NWFSC-OA-lab/field_sensors/images/DataSheet Images/Pico-pH Parts.PNG

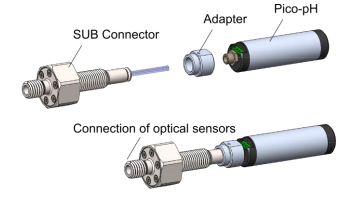
images/DataSheet Images/Pico-pH Parts.PNG
