NWFSC-OA-lab/field_sensors/README.md

# field_sensors
Repo for field sensor team files, issues and code
