NWFSC-OA-lab/field_sensors/ShuckMaster/README.md

# Logger
Arduino code for a Shuckmaster

## Features
 * Receives commands and responds over Bluetooth
 * Stores persistent configuration settings
   * Measurement period
   * Calibration constants
 * Keeps track of persistent time through an RTC module
 * Stores data on a microSD card
