NWFSC-OA-lab/field_sensors/ShuckManagerNew/ShuckManager/README.md

# ShuckManager
Android app mediating between the Shuckmaster and web server

## Features
 * Scans for nearby Shuckmasters and allows connection
 * Request data between two dates, then forward it to the web server
 * Configure a connected Shuckmaster
 * Set calibration constants on a connected Shuckmaster based on measurements in a standard solution
 * Request health of components on a connected Shuckmaster
