NWFSC-OA-lab/field_sensors/images/Conductivity sensor connections.PNG

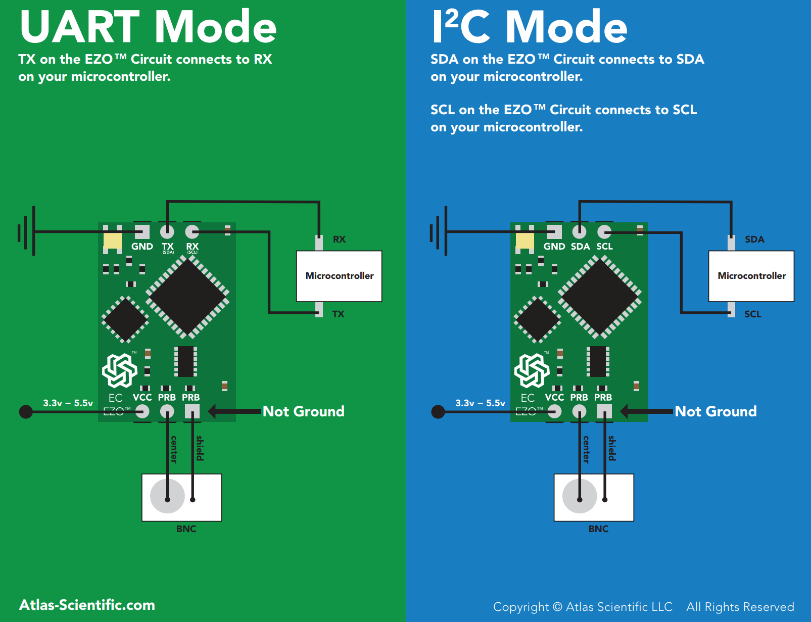
images/Conductivity sensor connections.PNG
