NWFSC-OA-lab/field_sensors/images/Conductivity Sensor/I2C Commands.PNG

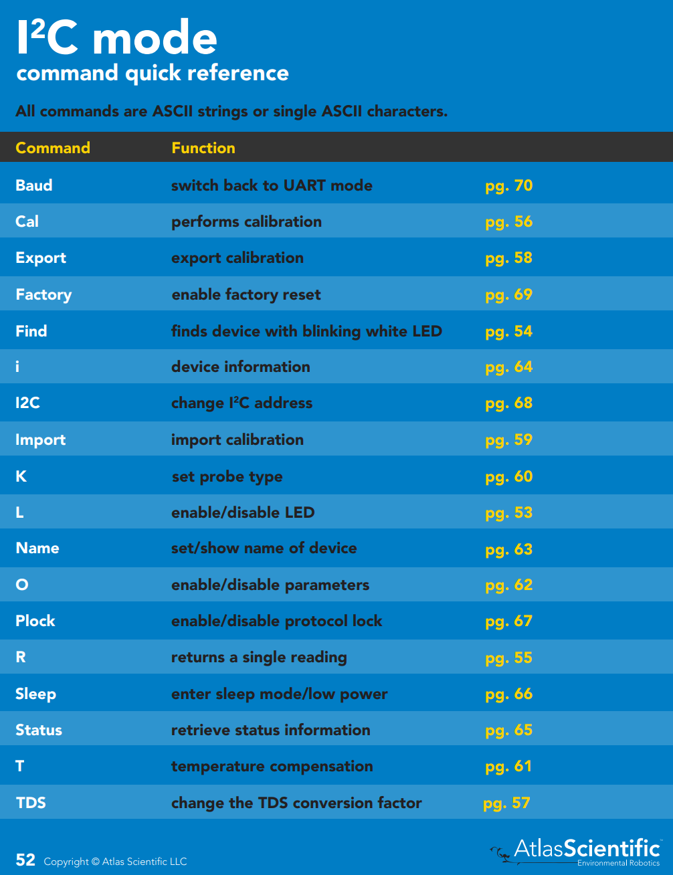
images/Conductivity Sensor/I2C Commands.PNG
