NWFSC-OA-lab/field_sensors/images/Conductivity Sensor/power ratings.PNG

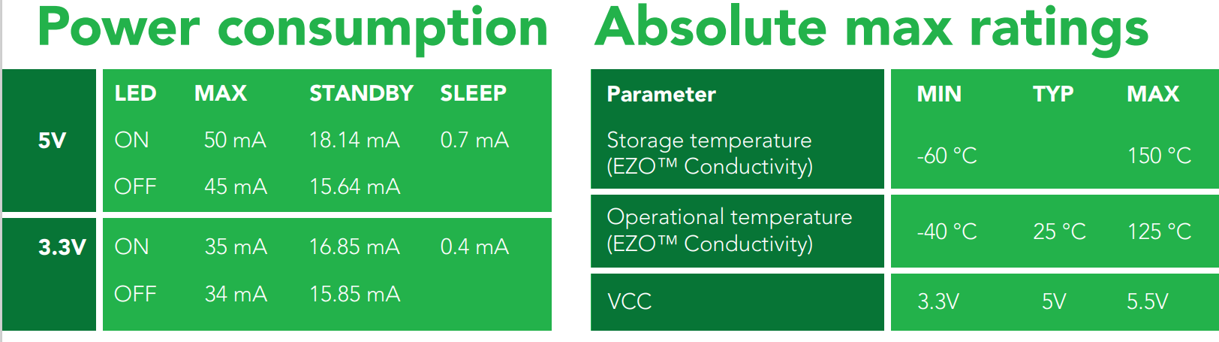
images/Conductivity Sensor/power ratings.PNG
