NWFSC-OA-lab/field_sensors/images/Conductivity Sensor/UART Commands.PNG

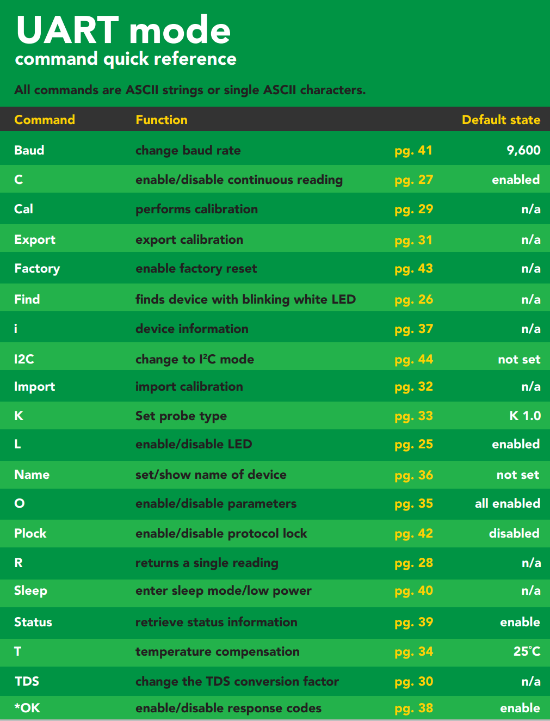
images/Conductivity Sensor/UART Commands.PNG
