NWFSC-OA-lab/field_sensors/images/DataSheet Images/conductivity sensor specifications.PNG

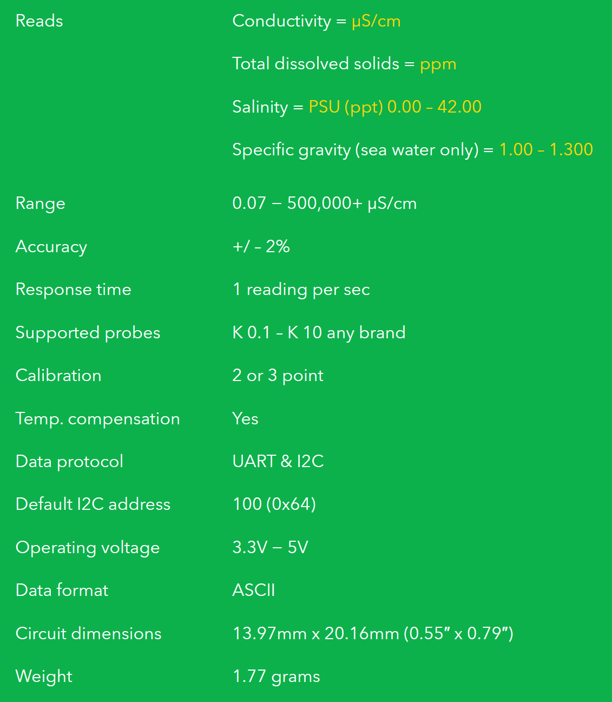
images/DataSheet Images/conductivity sensor specifications.PNG
