NWFSC-OA-lab/field_sensors/images/DataSheet Images/Durafet dimensions.PNG

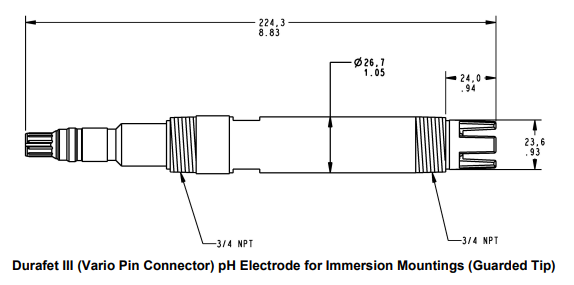
images/DataSheet Images/Durafet dimensions.PNG
