NWFSC-OA-lab/field_sensors/images/DataSheet Images/Durafet Specifications.PNG

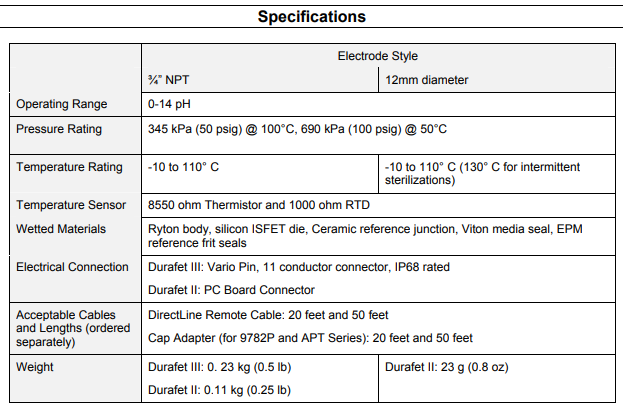
images/DataSheet Images/Durafet Specifications.PNG
