NWFSC-OA-lab/field_sensors/images/DataSheet Images/Pico-pH Specifications2.PNG

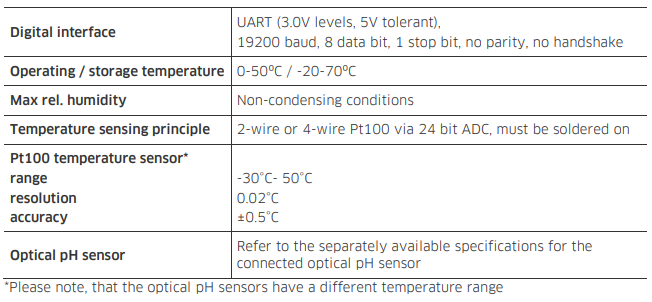
images/DataSheet Images/Pico-pH Specifications2.PNG
