NWFSC-OA-lab/field_sensors/images/DataSheet Images/Pico-pH Specifications.PNG

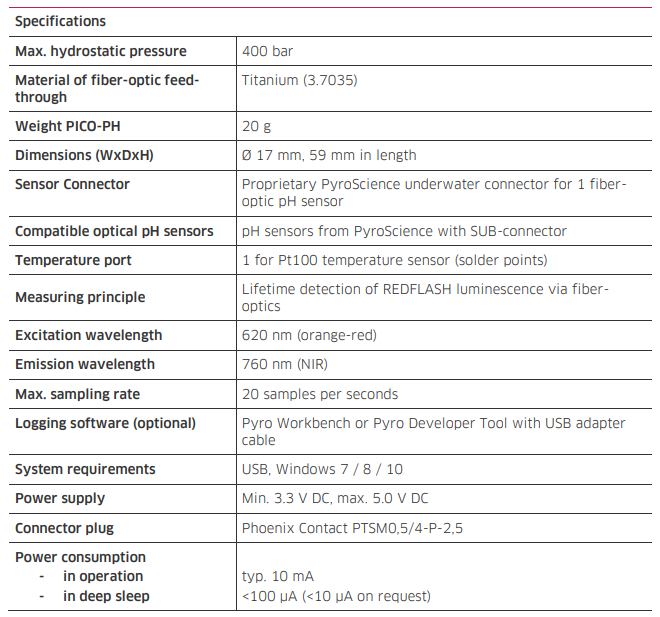
images/DataSheet Images/Pico-pH Specifications.PNG
