NWFSC-OA-lab/field_sensors/images/Schematic Images/ADC Schematic.PNG

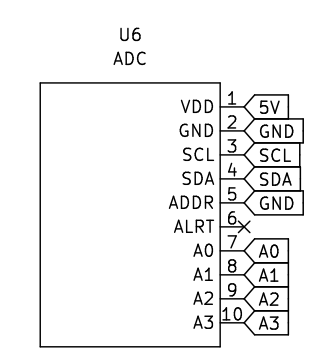
images/Schematic Images/ADC Schematic.PNG
