NWFSC-OA-lab/field_sensors/images/Schematic Images/Arduino Schematic.PNG

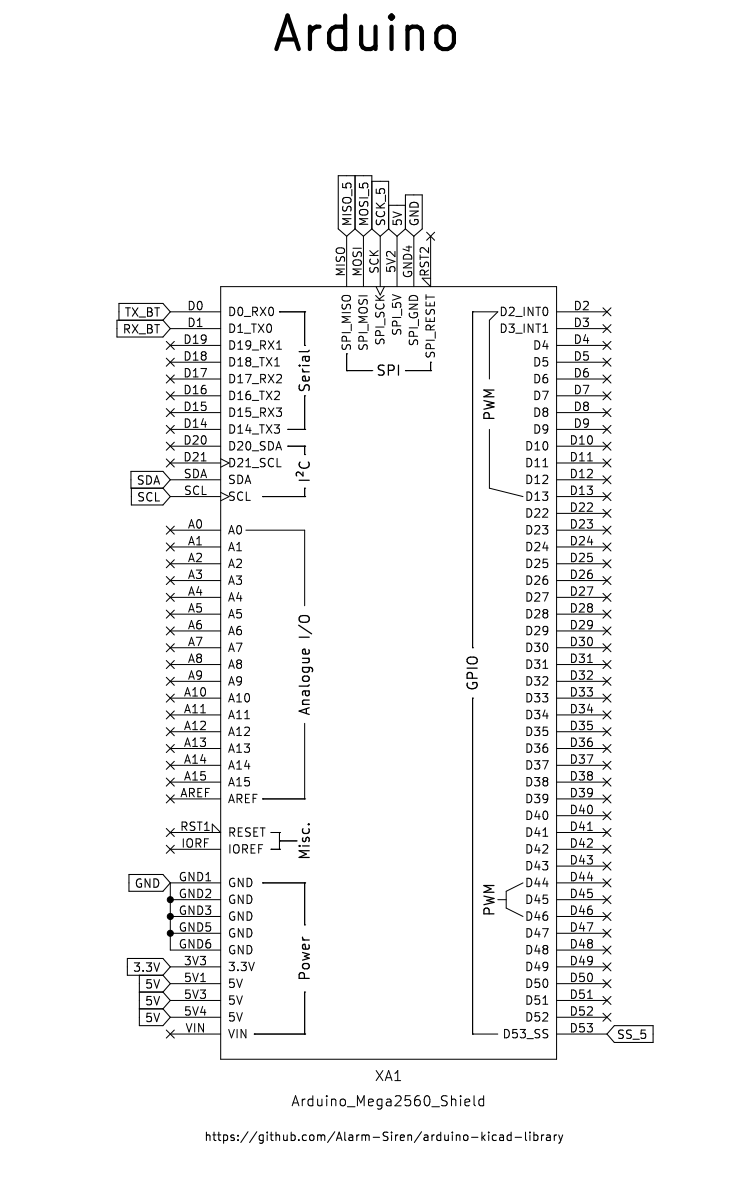
images/Schematic Images/Arduino Schematic.PNG
