NWFSC-OA-lab/field_sensors/images/Schematic Images/Barrel Jack Schematic.PNG

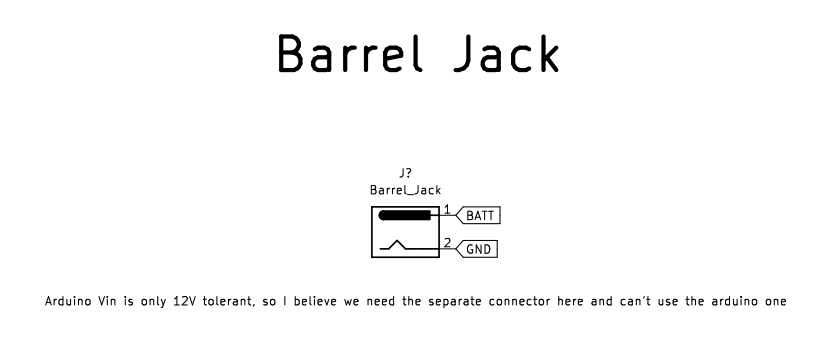
images/Schematic Images/Barrel Jack Schematic.PNG
