NWFSC-OA-lab/field_sensors/images/Schematic Images/Bluetooth Schematic.PNG

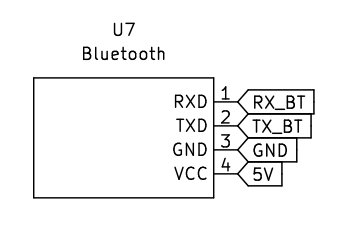
images/Schematic Images/Bluetooth Schematic.PNG
