NWFSC-OA-lab/field_sensors/images/Schematic Images/I2C Schematic.PNG

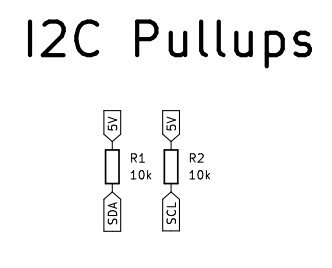
images/Schematic Images/I2C Schematic.PNG
