NWFSC-OA-lab/field_sensors/images/Schematic Images/Level Shifter Schematic.PNG

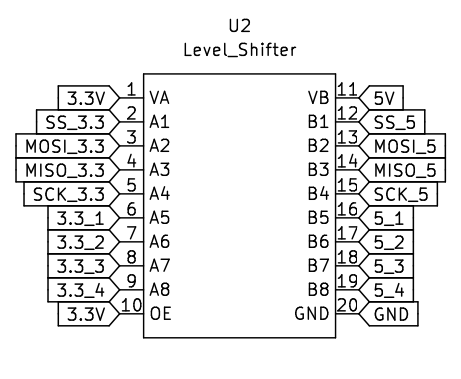
images/Schematic Images/Level Shifter Schematic.PNG
