NWFSC-OA-lab/field_sensors/images/Schematic Images/PCB design.PNG

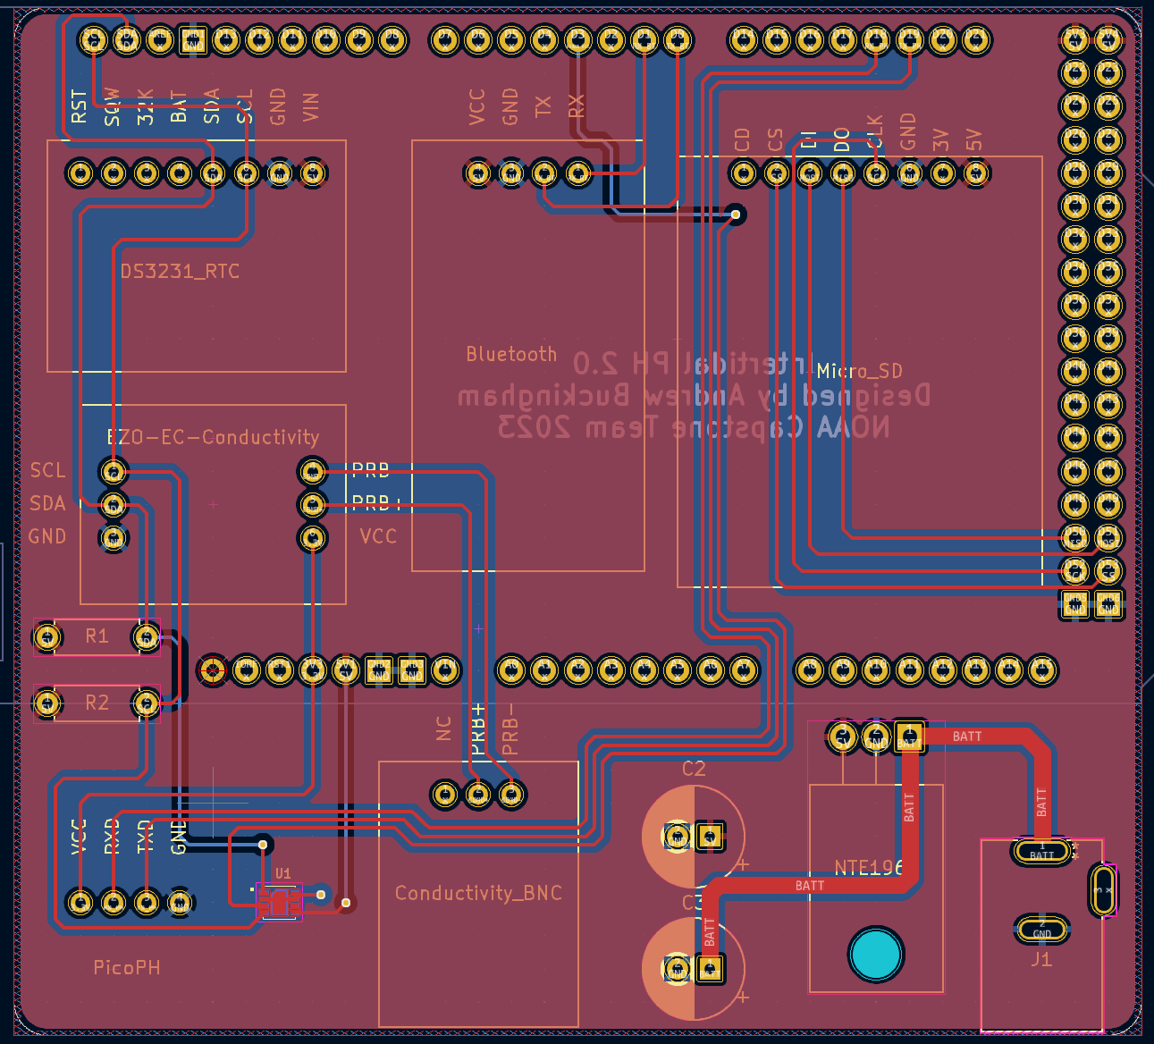
images/Schematic Images/PCB design.PNG
