NWFSC-OA-lab/field_sensors/images/Schematic Images/Power Flags Schematic.PNG

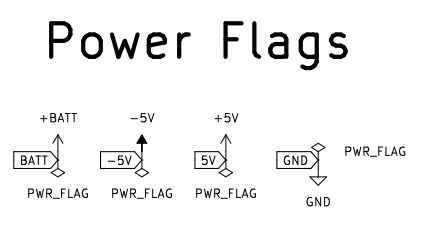
images/Schematic Images/Power Flags Schematic.PNG
