NWFSC-OA-lab/field_sensors/images/Schematic Images/SD Reader Schematic.PNG

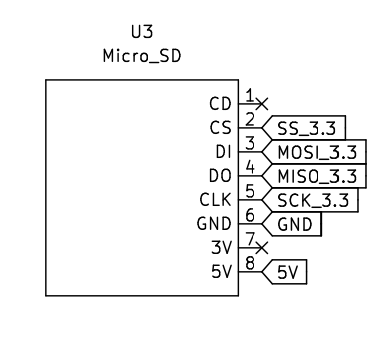
images/Schematic Images/SD Reader Schematic.PNG
