NWFSC-OA-lab/field_sensors/images/Schematic Images/Voltage Regulator Schematic.PNG

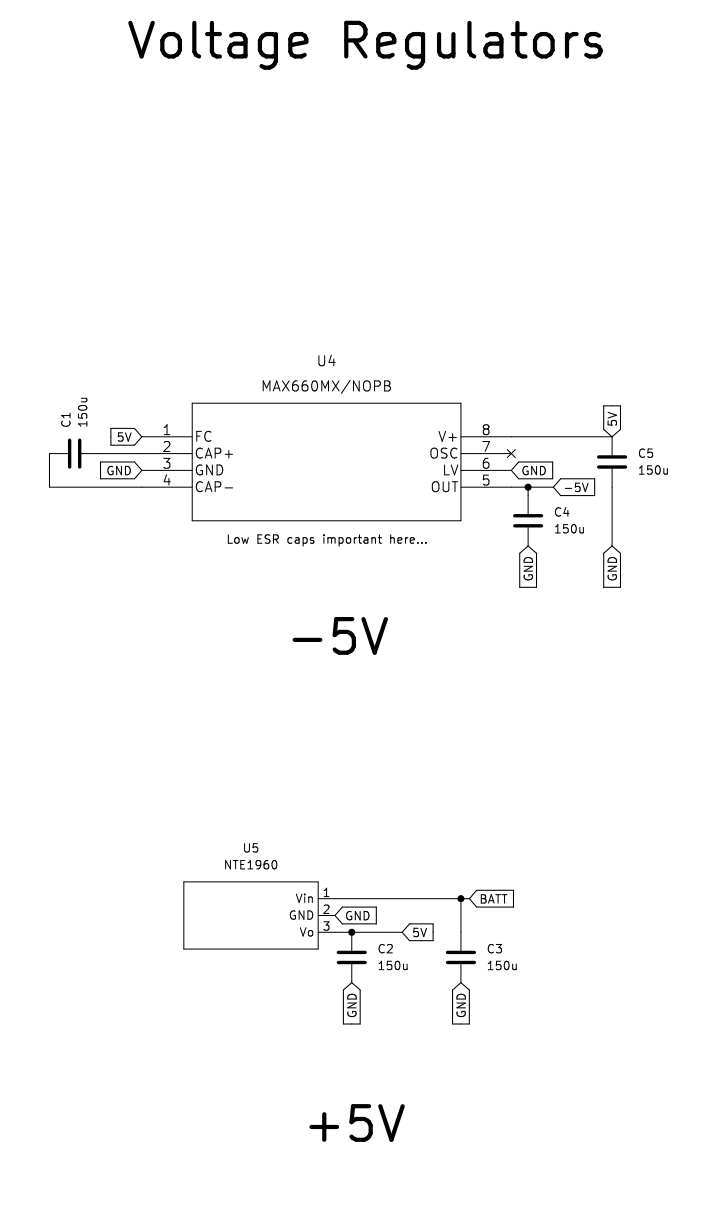
images/Schematic Images/Voltage Regulator Schematic.PNG
