NWFSC-OA-lab/field_sensors/images/Schematic Images/PCB components.PNG

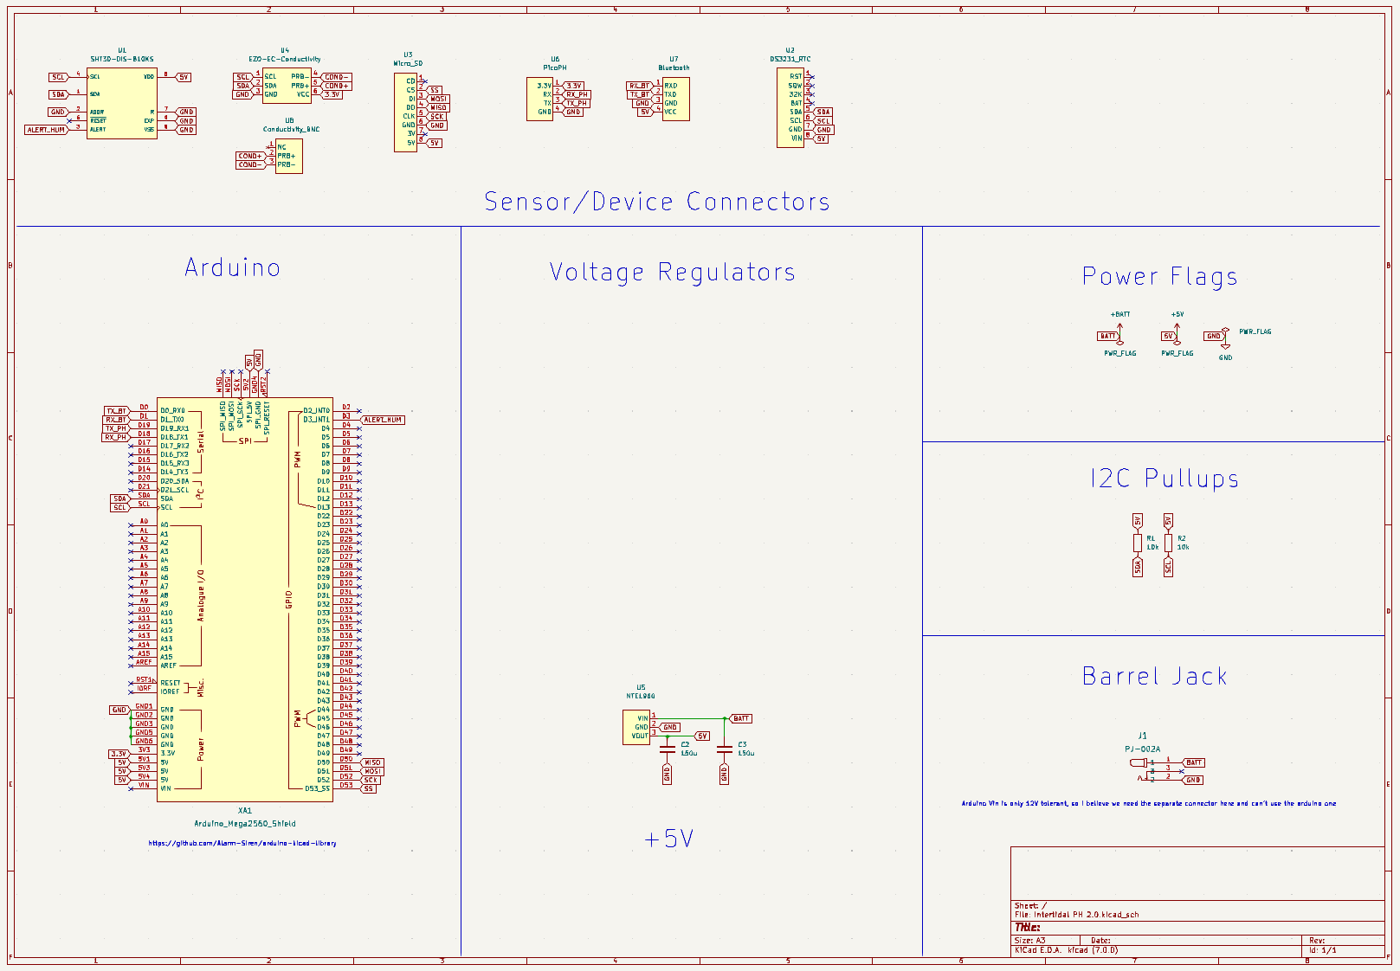
images/Schematic Images/PCB components.PNG
