NWFSC-OA-lab/field_sensors/images/Schematic Images/Durafet Wiring Schematic.PNG

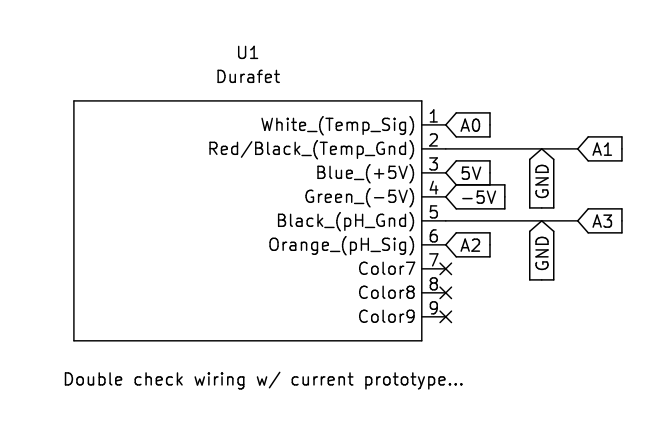
images/Schematic Images/Durafet Wiring Schematic.PNG
