NWFSC-OA-lab/field_sensors/(threads)

Thread 2 (2022-01-16):

Team roles

pmcelhany, 2022-01-16:
Assign team roles...

pmcelhany, 2022-02-07:
- Durafet (reading, recording, commicat with sensor, etc.)
- Communication (celluar, bluetooth, alarms)
-  battery (power management and reprting )
- Housing, mechanical (waterproofing pumps)
- analysis software (user interface, live update alarms)

pmcelhany, 2023-01-10:
Capstone 22 issue

Thread 4 (2022-01-26):

Communication Research

AaronDyer13, 2022-01-26:
-(Updated 1/26) Communication options presented at Monday meeting. Currently considering GSM and LTE options, and considering service providers based upon cost and coverage. GSM preferred at the moment, although LTE provides longer-term service. Specific modules tend to be suited for specific microcontrollers, so our choice will depend on microcontroller selection.

pmcelhany, 2023-01-10:
Capstone 22 issue

Closed 2023-01-10.

Thread 5 (2022-01-26):

Microcontroller Research

AaronDyer13, 2022-01-26:
- (Updated 1/26) Microcontroller options presented in Monday meeting. Specification narrowed; requirements now include storage slot (SD card?), low power draw (Raspberry Pi not realistic). Awaiting expertise from UW Oceanography on Monday meeting (1/21)

pmcelhany, 2022-04-26:
Selected Aurdino

Closed 2022-04-26.

Thread 6 (2022-01-26):

Housing Research/ Initial Design

AaronDyer13, 2022-01-26:
-(Updated 1/26) Initial housing design draft completed, potential issues with PVC connection sealing. Meeting set up with UW Oceanography to discuss best practices and materials for design (Jan. 31), will revise design accordingly

pmcelhany, 2023-01-10:
Capstone 22 issue

Closed 2023-01-10.

Thread 11 (2022-04-26):

Pump system

pmcelhany, 2022-04-26:
- [ ] Order relay module (UW)
- [ ] Delivery of rely to SAFS
- [ ] Delivery of relay ot UW team

pmcelhany, 2022-05-17:
2022.05.17

- will start working on this with new parts that just arrived

pmcelhany, 2023-01-10:
Capstone 22 issue

Closed 2023-01-10.

Thread 12 (2022-04-26):

Web app

pmcelhany, 2022-04-26:
- [x] Preliminary design of web app interface (2022.04.26)
- [x] Review preliminary design

pmcelhany, 2022-04-26:
Update
[Interface doc](https://docs.google.com/document/d/1fEuwa57X2if4j0FIOUwNqlYIXv_eCr1Zn2rY9eV4Enk/edit)

sjhwa, 2022-05-03:
- [ ] Get web server up and running and feed it sample data from Android app (5/4/2022)
- [ ] Implement Web Page for downloading CSV file for time-series data (5/72022)
- [ ] Provide Core UI features (Email Alerts, Selection of Data over periods of time in table-format) (5/10/2022)
- [ ] Server Cost analysis (5/10/2022)
- [ ] Implement Additional UI Features (Sensor Selection, Data Visualization) (5/15/2022 <- original due date)

pmcelhany, 2022-05-03:
looks like a good list

pmcelhany, 2022-05-04:
alarms not essential until we get continuous live communication

pmcelhany, 2022-05-17:
2022.05.17

- connect with sebas

sjhwa, 2022-05-17:
- [ ] Set up server for public Traffic (5/17/2022)
- [ ] Send Sebastian HTTP code info (5/17/2022)
- [ ] Continue with UI Dev (and keep team updated through email!)

pmcelhany, 2022-05-24:
2022.05.24

- [ ] get url to sebastian (need to modify security) do this afternoon
- [ ] options for sensor calibration data, alarms, new measurements, lat-lon google map

sjhwa, 2022-05-26:
- [ ] Feed sample data from Android app for demo
- [ ] Server side: fix missing parameters error
- [ ] Client side: add more chart options, column names for output file
- [ ] Client side: fix user log in screen (i.e. fix deprecated node modules)
- [ ] Feed sample data from Android app for demo

Documentation:
- [ ] analyze server costs, domain name, and possible database needs
- [ ]
- [ ]
- [ ] Continue server Handle

pmcelhany, 2023-01-10:
Capstone 22 issue

Closed 2023-01-10.

Thread 13 (2022-04-26):

Bluetooth

pmcelhany, 2022-04-26:
- [ ] Review status of bluetooth communication (2022.04.26_

pmcelhany, 2022-04-26:
Ad option to get instrument status on bluetooth

pmcelhany, 2022-05-04:
- Can send message from aurdino
- need to check sensor
- pull data
- calibrate (paul write steps for calibration)
- start/stop collecting data
-How do we start the aurdino

pmcelhany, 2022-05-10:
2022.05.10

- can send and receive packets
- waiting for info from sarah on web connections
- What will be in the packets (4-5 types)
- Send to sensor
-     request data
-      request sensor health
-     basic ping
-     configuration
-     start calibration
-

pmcelhany, 2022-05-10:
Configuration

- time
- date
- calibration pH
- calibration temperature
- calibration voltage
- temperature calibration offset

Separate packet tide table (not as high a priority)

- date
- time
- pump on/off

pmcelhany, 2022-05-24:
finished sensor up of update reading
working on sensor health
- [ ] Add option to clear the SD card (give a warning about this!)
- [ ] Warning if SD card is near full (how much longer until out of space)
- [ ] Set up reading data with Isaiah
- [ ] report when the last data pulled
- [ ] Need url from sarah

pmcelhany, 2022-05-31:
not tide table yet

pmcelhany, 2023-01-10:
Capstone 22 issue

Closed 2023-01-10.

Thread 15 (2022-04-26):

Batteries

pmcelhany, 2022-04-26:
Waiting for arrival of 12V batteries

pmcelhany, 2022-05-04:
Batteries arrived and looked good (not too heavy)

pmcelhany, 2022-05-17:
2022.05.17

- may need to switch battery cables (too stiff)
- did testing last week
- voltage regulator (10V) put out too much voltage
- Adding capacitors; will try this week

pmcelhany, 2023-01-10:
Capstone 22 issue

Closed 2023-01-10.

Thread 8 (2022-04-26):

Bench test durafet with labview

pmcelhany, 2022-04-26:
- [ ] Wire plug-in power supply,, durafet, labjack, computer
- [ ] Test durafet with windows and labjack software
- [ ]  Read labjack with aurdino

pmcelhany, 2022-04-26:
Will plan to start step one on 2022.04.26 at 4:00
@michaelmaher114 Can you join the UW team to talk about durafet and labjack, etc. at 4:00 today? perhaps in person at UW oceanograhy?

pmcelhany, 2022-04-26:
Research purchase of 24 bit A-to-D aurdino module.

pmcelhany, 2022-04-26:
@NWFSC-OA-lab/field-sensors-team Mike can join your durfet wiring meeting at 4:00 today. I sent a calendar invite.

AaronDyer13, 2022-04-26:
> @NWFSC-OA-lab/field-sensors-team Mike can join your durfet wiring meeting at 4:00 today. I sent a calendar invite.

Sounds good, thanks!

pmcelhany, 2022-05-04:
- Currently testing with 16bit atd (weird results?)
- need to get 24bit (get it working with 16bit if 24 bit not available). Should be easy to swap atod modules.
- 16bit a to d are pretty available

pmcelhany, 2022-05-10:
2022.05.10

- reading voltage into

pmcelhany, 2022-05-10:
@michaelmaher114 Do we have some tris for durafet calibration we can use for the sensor project?

pmcelhany, 2022-05-17:
2022.05.17
same tasks as last week

pmcelhany, 2023-01-10:
Capstone 22 issue

Closed 2023-01-10.

Thread 9 (2022-04-26):

Housing design

pmcelhany, 2022-04-26:
- [ ] 3d drawing of housing design
- [ ] design of any 3d printed parts

pmcelhany, 2022-05-17:
2022.05.17

- OTB051 oceography lab
- working on main housing
- Craig over lab this afternoon
- ideas from oceanography on holes for cables
- still working on how to put components into sensor

pmcelhany, 2023-01-10:
Capstone 22 issue

Closed 2023-01-10.

Thread 16 (2022-05-04):

housing construction

pmcelhany, 2022-05-04:
- [ ] glue end adaptors
- [ ] water test caps (wrap with teflon tape) Need wide tape?
- [ ] then holes for durafet and pump cables (check Rick about this)
- [ ] How to pack insides? (foam, pvc standoff)

pmcelhany, 2023-01-10:
Capstone 22 issue

Closed 2023-01-10.

Thread 18 (2022-05-17):

Sensor calibration SOP

pmcelhany, 2022-05-17:
- [x] Paul draft sensor calibration SOP
- [ ] Review calibration SOP with Isaiah, Craig and Sebastian

pmcelhany, 2022-05-24:
- [ ] find citation for function in "tris pH calculator"

pmcelhany, 2023-01-10:
Capstone 22 issue

Closed 2023-01-10.

Thread 19 (2023-01-10):

Team roles

pmcelhany, 2023-01-10:
- [ ] Define role categories
- [ ] Initial role assignments

ajbuckingham00, 2023-01-17:
For this week, we have divided up work as follows:

Housing Review: Andrew
Arduino Code/Sensor Review: Tyler and Kevin
Communications (Server/App): Gen
Electronics/PCB Review: Andy

We may change responsibilities a bit as time goes on if we find this isn't a good fit or if one part needs more or less work than another.

Thread 21 (2023-01-10):

Hardware management

pmcelhany, 2023-01-10:
- [ ] Inventory initial hardware
- [ ] Identify where hardware stored
- [ ] Identify how to transfer hardware

pmcelhany, 2023-01-17:
I have another box of hardware that I will bring to the meeting today. It include some Arduino boards and other components.

ajbuckingham00, 2023-01-17:
All hardware is currently stored at our desk in the capstone work space, which is under keycard access.

axiongH, 2023-01-18:
I'm currently working on creating an inventory list of all of our supplies, but I'll make a separate inventory list for the prototype's hardware

axiongH, 2023-01-21:
Added a google doc in our drive that keeps inventory of what we currently have in the boxes, as well as what the prototype is using

Thread 23 (2023-01-10):

Arduino code review

pmcelhany, 2023-01-10:
- [ ] Decide on Arduino IDE platform
- [ ] Review existing code
- [ ] Load libraries for existing code

ajbuckingham00, 2023-01-24:
We started by running example code for all of the sensors on the arduino, which let us verify that they were working and brought to light a few issues with the PCB (see the electronics update for more detail).

We were able to run last years code on the device, and successfully initialize all the sensors (and communicate with all of them except maybe the bluetooth. We weren't able to connect the device to the app, but aren't sure if that is a bluetooth module issue or an app issue yet).

We still need to verify bluetooth connectivity, and make a few changes to the code since we are using a different ADC (the 16 bit one was broken, we installed the 12 bit one instead). Will be working on that this week.

Thread 24 (2023-01-10):

Version 1 electronics test

pmcelhany, 2023-01-10:
- [ ] Review schematic of prototype 1
- [ ] Verify components/wiring of prototype 1 board
- [ ] Work with Arduino code to test components on prototype 1 board

axiongH, 2023-01-21:
1/21: Tested most of the components individually. ADC1115 and Bluetooth Module are still under testing.
- ADC1115 requires a pull-up resistor for the SCL and SDA line to use the I2C
- Bluetooth module requires the use of an app so that we need to figure out how to use so this one is taking a bit longer

ajbuckingham00, 2023-01-24:
In addition to the items above, we fixed several soldering issues on the board. We were unable to fix the soldering on the ADC board (I think either the pads are lifted or they are corroded/damaged somehow, solder would not stick to them at all even after cleaning with alcohol), so we installed the 12 bit ADC instead and were able to use that.

axiongH, 2023-02-08:
We were able to connect to the app, however, we are not yet able to pull data from the SD card

Thread 28 (2023-01-11):

Housing review

pmcelhany, 2023-01-11:
- [ ] Review current housing
- [ ] Look a SAFS shop options
- [ ] Look 3-D printer

CraigNorrie, 2023-01-15:
We have just been offered up 6 aluminium cans that are rated for ~1000m depth ("I have 2 of the smaller ones and 5 of the bigger ones. They have O-rings and 2-3 holes each for terminator ends."). These may be a good option to adapt for this project.

I will pick these up on Wednesday so once we have decided who will be working on housings we can organise a hand off of these.

Also, on the housing end I have used t[his company, Blue robotics](https://bluerobotics.com/), to purchase cable pass throughs to get cables into the housing.

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

ajbuckingham00, 2023-01-24:
https://docs.google.com/document/d/1tTLNvvjGGg6psoWKbbJDTTxCdVLFyZhsqk0whiyrYP8/edit

Housing research doc from last week, with several useful papers linked

Thread 29 (2023-01-11):

Review kicad for prototype 1

pmcelhany, 2023-01-11:
- [ ] If you don't have it already, install the latest kicad
- [ ] If you are not familiar with kicad, watch a few online tutorials
- [ ] Download and review Paul's prototype 1 kicad files located [here](https://drive.google.com/drive/folders/12GNq0-11jScPFHjq4TRIzMbIWGvSqzZs?usp=share_link).

axiongH, 2023-01-21:
-Need to add pull-up resistors to the ADC clock and data line

Thread 30 (2023-01-11):

Research pico pH sensor

pmcelhany, 2023-01-11:
In addition to the Durafet pH probe, we will develop a system that  also works with the pico probe.

- [ ] Research power and communication requirements for the[ Pyroscience Pico pH meter](https://www.pyroscience.com/en/products/all-meters/pico-ph-sub).

Thread 32 (2023-01-24):

Calibrating Sensors

sakura-gen, 2023-01-24:

sakura-gen, 2023-01-25:
@pmcelhany please bring trisolution during next week's meeting

sakura-gen, 2023-02-08:
@pmcelhany We're having some trouble figuring out the equations last year's team used for determining pH measurements. Would you be able to help us break it down in a zoom call or meeting?

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

sakura-gen, 2023-02-14:
Was unable to calibrate the Durafet and we were getting voltage readings of 0.76 V although the expected readings were in the range of 0.01-0.05 V. We attempted to hook up the durafet to the intended +-5V power but got different readings. We hope to go over how to troubleshoot this during our update meeting tomorrow.

sakura-gen, 2023-02-15:
@pmcelhany

[Durafet II manual.pdf](https://github.com/NWFSC-OA-lab/field_sensors/files/10738459/Durafet.II.manual.pdf)
