NWFSC-OA-lab/field_sensors/(commit log)

2022-05-31 Added android app and arduino program
2022-06-01 Added timed relay toggling mechanism
2023-02-22 Add modified Arduino Code
    Current working version
2023-03-05 Update ReceivedPacketAdapter.kt
    Added the functions that take apart the packets and prints out the data to the app
2023-03-05 Create Ezo_i2c.cpp
    This is the .cpp file for the salinity sensor
2023-03-05 Create Ezo_i2c.h
    This is the .h file for the salinity sensor
2023-03-05 Create Ezo_i2c_util.cpp
    Added a util file for the salinity sensor
2023-03-05 Create Ezo_i2c_util.h
    Added the .h file for the salinity sensor util file
2023-04-24 Create arudino_mega_EC_samplecodenw.ino
    This is a sample code for the EC salinity sensor
2023-05-09 Update shuckMasterNew.ino
    -Implemented fully working .csv file creator
    -Wrote code for Pico but need to test with the device
    -Cleaned up code a bit and got rid of durafet and other unnecessary code
2023-05-09 Update MainActivity.kt
    -removed the voltage label and added lowPh and highPH to the calibration
2023-05-10 Update shuckMasterNew.ino
    -implemented Pico sensor
    -TODO: Add pico calibration
2023-05-10 Update shuckmaster.ino
    -Added pico and salinity
    -got rid of durafet stuff
2023-05-10 Update MainActivity.kt
    -added calibration stuff for ph and temp
2023-05-10 Update Packets.h
    -Added the calibration stuff for ph and conductivity
2023-05-10 Update shuckmaster.ino
    added pico calibration
2023-05-19 Update shuckmaster.ino
    Updated the code to include the salinity sensor, pico stuff, current reading, and removed all of the durafet stuff
2023-05-19 Update activity_main.xml
    added the current reading button
2023-05-19 Update MainActivity.kt
    Added the current reading button
2023-05-19 Update ReceivedPacketAdapter.kt
    Added the current reading case
2023-05-19 Update PacketType.kt
    Added packets for the different types of errors, and the current reading packet
2023-05-31 Update shuckmaster.ino
    Moved the current_sending stuff
